rt-net/mevius2/AddInfo/imgs/Picture(6).png

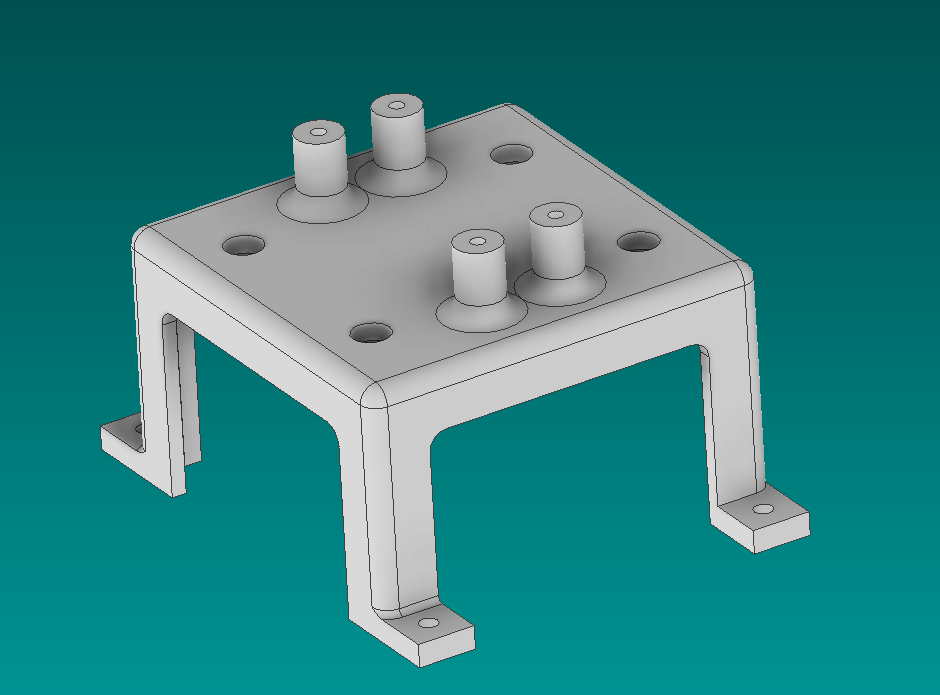
AddInfo/imgs/Picture(6).png
