rt-net/mevius2/AddInfo/Hardware/STL/Lidar-C1unit-Mount.stl

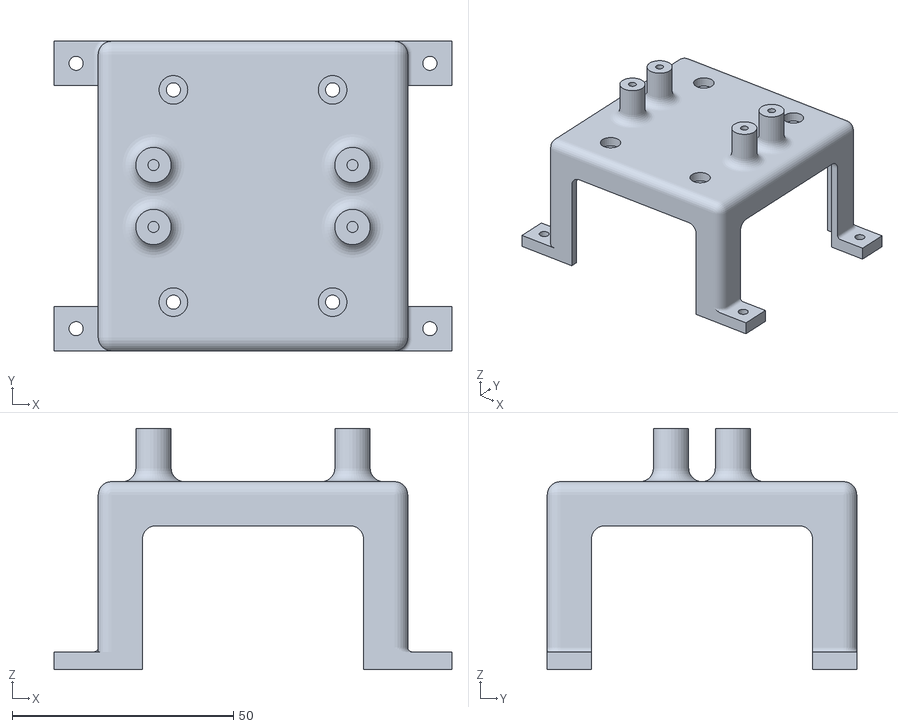
[picture p3: CAD file, 2026-10-27]
AddInfo/Hardware/STL/Lidar-C1unit-Mount.stl
90.0 x 70.0 x 54.5
