rt-net/mevius2/AddInfo/Hardware/STL/Jetson-Mount_LAN_Holder.stl

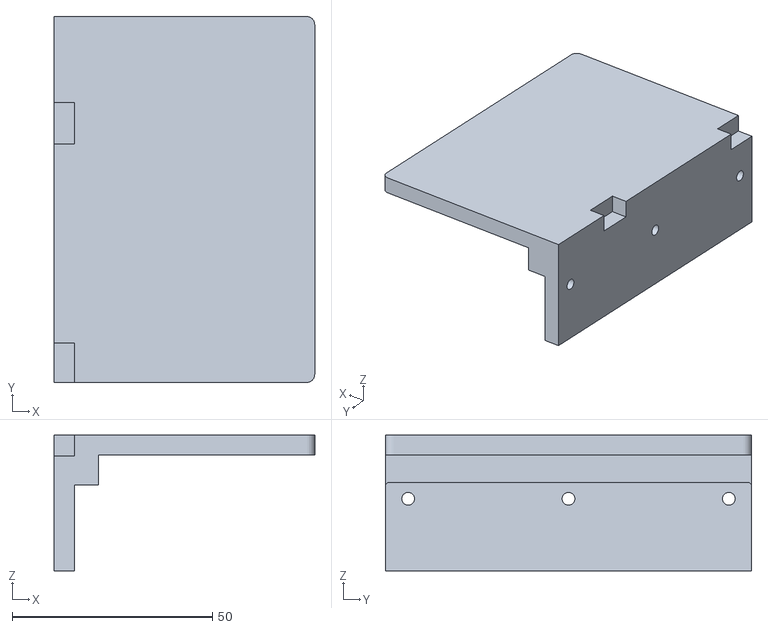
[picture p4: CAD file, 2026-10-27]
AddInfo/Hardware/STL/Jetson-Mount_LAN_Holder.stl
65.0 x 91.3 x 33.9
