rt-net/mevius2/models/mevius2_dae.urdf

<?xml version='1.0' encoding='UTF-8'?>
<robot name="mevius2">
  <link name="base_link">
    <inertial>
      <origin xyz="0.0165960147853653 0.0 0.0549872300199948" rpy="0.0 -0.0 0.0"/>
      <mass value="9.62592165123087"/>
      <inertia ixx="0.0238411422985121" ixy="-7.82998515474365e-06" ixz="0.000608822050897311" iyy="0.0277489409503768" iyz="3.45214164930493e-06" izz="0.0412615906790852"/>
    </inertial>
    <visual>
      <geometry>
        <mesh filename="package://mevius2/models/meshes/base_link.dae"/>
      </geometry>
      <origin xyz="0.0 0.0 0.0" rpy="0.0 -0.0 0.0"/>
    </visual>
    <collision>
      <geometry>
        <box size="0.40 0.211 0.190"/>
      </geometry>
      <origin xyz="0.0 0.0 0.065" rpy="0.0 0.0 0.0"/>
    </collision>
    <collision>
      <geometry>
        <box size="0.07 0.09 0.125"/>
      </geometry>
      <origin xyz="0.368 0.0 0.0625" rpy="0.0 0.0 0.0"/>
    </collision>
  </link>
  <link name="FR_scapula_link">
    <inertial>
      <origin xyz="0.0597359186912743 0.00851610127542549 4.7319717203384e-05" rpy="0.0 -0.0 0.0"/>
      <mass value="1.10755855898182"/>
      <inertia ixx="0.000951820798436067" ixy="-4.20483043113043e-05" ixz="-1.01679999721395e-06" iyy="0.00163047649310399" iyz="-1.28863656505179e-07" izz="0.000884794532952109"/>
    </inertial>
    <visual>
      <geometry>
        <mesh filename="package://mevius2/models/meshes/FR_scapula_link.dae"/>
      </geometry>
      <origin xyz="0.0 0.0 0.0" rpy="0.0 -0.0 0.0"/>
    </visual>
    <collision>
      <geometry>
        <cylinder radius="0.0625" length="0.139"/>
      </geometry>
      <origin xyz="0.0625 -0.0405 0" rpy="1.57 0.0 0.0"/>
    </collision>
  </link>
  <link name="FR_thigh_link">
    <inertial>
      <origin xyz="-0.00546146732125641 -0.05295120372457 -0.0482986549914968" rpy="0.0 -0.0 0.0"/>
      <mass value="1.82653549402785"/>
      <inertia ixx="0.00773006083782414" ixy="-6.24664521180222e-07" ixz="-0.000359149238289752" iyy="0.00887978884347362" iyz="1.51122631673122e-06" izz="0.00131524852670661"/>
    </inertial>
    <visual>
      <geometry>
        <mesh filename="package://mevius2/models/meshes/FR_thigh_link.dae"/>
      </geometry>
      <origin xyz="0.0 0.0 0.0" rpy="0.0 -0.0 0.0"/>
    </visual>
  </link>
  <link name="FR_calf_link">
    <inertial>
      <origin xyz="0.00652657289495578 -6.41512646251674e-06 -0.121361151716941" rpy="0.0 -0.0 0.0"/>
      <mass value="0.266052320574036"/>
      <inertia ixx="0.0015552365359667035" ixy="9.175141422809164e-09" ixz="6.1865695511078285e-06" iyy="0.0015697368632454998" iyz="-9.90647529080357e-08" izz="4.624075442654299e-05"/>
    </inertial>
    <visual>
      <geometry>
        <mesh filename="package://mevius2/models/meshes/FR_calf_link.dae"/>
      </geometry>
      <origin xyz="0.0 0.0 0.0" rpy="0.0 -0.0 0.0"/>
    </visual>
    <collision>
      <geometry>
        <box size="0.021 0.021 0.310"/>
      </geometry>
      <origin xyz="0.01305 0.0 -0.135" rpy="0.0 0.0 0.0"/>
    </collision>
  </link>
  <link name="FR_foot_link">
    <inertial>
      <origin xyz="0.0 0.0 0.0" rpy="0.0 0.0 0.0"/>
      <mass value="0.12"/>
      <inertia ixx="5.3e-05" ixy="0.0" ixz="0.0" iyy="5.3e-05" iyz="0.0" izz="5.3e-05"/>
    </inertial>
    <collision>
      <geometry>
        <sphere radius="0.03"/>
      </geometry>
      <origin xyz="0.0 0.0 0.0" rpy="0.0 0.0 0.0"/>
      <material name="foot">
        <color rgba="1 0 0 1" />
      </material>
    </collision>
  </link>
  <link name="FL_scapula_link">
    <inertial>
      <origin xyz="0.059735918691274 -0.00851610127542556 -4.73197172033216e-05" rpy="0.0 -0.0 0.0"/>
      <mass value="1.10755855898183"/>
      <inertia ixx="0.000951820798436068" ixy="4.20483043113044e-05" ixz="1.01679999721443e-06" iyy="0.00163047649310399" iyz="-1.28863656505136e-07" izz="0.000884794532952109"/>
    </inertial>
    <visual>
      <geometry>
        <mesh filename="package://mevius2/models/meshes/FL_scapula_link.dae"/>
      </geometry>
      <origin xyz="0.0 0.0 0.0" rpy="0.0 -0.0 0.0"/>
    </visual>
    <collision>
      <geometry>
        <cylinder radius="0.0625" length="0.139"/>
      </geometry>
      <origin xyz="0.0625 0.0405 0" rpy="1.57 0.0 0.0"/>
    </collision>
  </link>
  <link name="FL_thigh_link">
    <inertial>
      <origin xyz="-0.00546146732125286 0.0529459082875361 -0.0482412683620331" rpy="0.0 -0.0 0.0"/>
      <mass value="1.82653549402785"/>
      <inertia ixx="0.00773006083782417" ixy="6.24664521188713e-07" ixz="-0.000356450328025656" iyy="0.0088797888434736" iyz="-1.25349900371468e-06" izz="0.00131524852670654"/>
    </inertial>
    <visual>
      <geometry>
        <mesh filename="package://mevius2/models/meshes/FL_thigh_link.dae"/>
      </geometry>
      <origin xyz="0.0 0.0 0.0" rpy="0.0 -0.0 0.0"/>
    </visual>
  </link>
  <link name="FL_calf_link">
    <inertial>
      <origin xyz="0.00652657289495667 -6.41512646301634e-06 -0.121361151716941" rpy="0.0 -0.0 0.0"/>
      <mass value="0.266052320574035"/>
      <inertia ixx="0.0015552365359667035" ixy="9.175141422809164e-09" ixz="6.1865695511078285e-06" iyy="0.0015697368632454998" iyz="-9.90647529080357e-08" izz="4.624075442654299e-05"/>
    </inertial>
    <visual>
      <geometry>
        <mesh filename="package://mevius2/models/meshes/FL_calf_link.dae"/>
      </geometry>
      <origin xyz="0.0 0.0 0.0" rpy="0.0 -0.0 0.0"/>
    </visual>
    <collision>
      <geometry>
        <box size="0.021 0.021 0.310"/>
      </geometry>
      <origin xyz="0.01305 0.0 -0.135" rpy="0.0 0.0 0.0"/>
    </collision>
  </link>
  <link name="FL_foot_link">
    <inertial>
      <origin xyz="0.0 0.0 0.0" rpy="0.0 0.0 0.0"/>
      <mass value="0.12"/>
      <inertia ixx="5.3e-05" ixy="0.0" ixz="0.0" iyy="5.3e-05" iyz="0.0" izz="5.3e-05"/>
    </inertial>
    <collision>
      <geometry>
        <sphere radius="0.03"/>
      </geometry>
      <origin xyz="0.0 0.0 0.0" rpy="0.0 0.0 0.0"/>
      <material name="foot">
        <color rgba="1 0 0 1" />
      </material>
    </collision>
  </link>
  <link name="BR_scapula_link">
    <inertial>
      <origin xyz="-0.059735918691274 0.00851610127542554 -4.73197172033493e-05" rpy="0.0 -0.0 0.0"/>
      <mass value="1.10755855898183"/>
      <inertia ixx="0.000951820798436068" ixy="4.20483043113042e-05" ixz="-1.01679999721433e-06" iyy="0.00163047649310399" iyz="1.28863656505235e-07" izz="0.000884794532952108"/>
    </inertial>
    <visual>
      <geometry>
        <mesh filename="package://mevius2/models/meshes/BR_scapula_link.dae"/>
      </geometry>
      <origin xyz="0.0 0.0 0.0" rpy="0.0 -0.0 0.0"/>
    </visual>
    <collision>
      <geometry>
        <cylinder radius="0.0625" length="0.139"/>
      </geometry>
      <origin xyz="-0.0625 -0.0405 0" rpy="1.57 0.0 0.0"/>
    </collision>
  </link>
  <link name="BR_thigh_link">
    <inertial>
      <origin xyz="-0.00548150334801351 -0.0529628356126009 -0.0487439292644921" rpy="0.0 -0.0 0.0"/>
      <mass value="1.82653549402785"/>
      <inertia ixx="0.00773006083782413" ixy="9.38683196344013e-07" ixz="-0.00035914923828971" iyy="0.0088797888434736" iyz="4.54484176825053e-07" izz="0.0013152485267066"/>
    </inertial>
    <visual>
      <geometry>
        <mesh filename="package://mevius2/models/meshes/BR_thigh_link.dae"/>
      </geometry>
      <origin xyz="0.0 0.0 0.0" rpy="0.0 -0.0 0.0"/>
    </visual>
  </link>
  <link name="BR_calf_link">
    <inertial>
      <origin xyz="0.00652657289495678 -6.41512646298859e-06 -0.121361151716941" rpy="0.0 -0.0 0.0"/>
      <mass value="0.266052320574035"/>
      <inertia ixx="0.0015552365359667035" ixy="9.175141422809164e-09" ixz="6.1865695511078285e-06" iyy="0.0015697368632454998" iyz="-9.90647529080357e-08" izz="4.624075442654299e-05"/>
    </inertial>
    <visual>
      <geometry>
        <mesh filename="package://mevius2/models/meshes/BR_calf_link.dae"/>
      </geometry>
      <origin xyz="0.0 0.0 0.0" rpy="0.0 -0.0 0.0"/>
    </visual>
    <collision>
      <geometry>
        <box size="0.021 0.021 0.310"/>
      </geometry>
      <origin xyz="0.01305 0.0 -0.135" rpy="0.0 0.0 0.0"/>
    </collision>
  </link>
  <link name="BR_foot_link">
    <inertial>
      <origin xyz="0.0 0.0 0.0" rpy="0.0 0.0 0.0"/>
      <mass value="0.12"/>
      <inertia ixx="5.3e-05" ixy="0.0" ixz="0.0" iyy="5.3e-05" iyz="0.0" izz="5.3e-05"/>
    </inertial>
    <collision>
      <geometry>
        <sphere radius="0.03"/>
      </geometry>
      <origin xyz="0.0 0.0 0.0" rpy="0.0 0.0 0.0"/>
      <material name="foot">
        <color rgba="1 0 0 1" />
      </material>
    </collision>
  </link>
  <link name="BL_scapula_link">
    <inertial>
      <origin xyz="-0.0597327134434165 -0.00851610127542554 4.73197172034118e-05" rpy="0.0 -0.0 0.0"/>
      <mass value="1.10755855898182"/>
      <inertia ixx="0.000951820798436067" ixy="-4.20483043113044e-05" ixz="1.01679999721446e-06" iyy="0.00163047649310399" iyz="1.28863656505084e-07" izz="0.000884794532952106"/>
    </inertial>
    <visual>
      <geometry>
        <mesh filename="package://mevius2/models/meshes/BL_scapula_link.dae"/>
      </geometry>
      <origin xyz="0.0 0.0 0.0" rpy="0.0 -0.0 0.0"/>
    </visual>
    <collision>
      <geometry>
        <cylinder radius="0.0625" length="0.139"/>
      </geometry>
      <origin xyz="-0.0625 0.0405 0" rpy="1.57 0.0 0.0"/>
    </collision>
  </link>
  <link name="BL_thigh_link">
    <inertial>
      <origin xyz="-0.00546146732125374 0.052955061332363 -0.0487439292644919" rpy="0.0 -0.0 0.0"/>
      <mass value="1.82653549402785"/>
      <inertia ixx="0.0077300608378242" ixy="6.24664521200288e-07" ixz="-0.000356450328025635" iyy="0.0088797888434736" iyz="-4.54484176825552e-07" izz="0.00131524852670657"/>
    </inertial>
    <visual>
      <geometry>
        <mesh filename="package://mevius2/models/meshes/BL_thigh_link.dae"/>
      </geometry>
      <origin xyz="0.0 0.0 0.0" rpy="0.0 -0.0 0.0"/>
    </visual>
  </link>
  <link name="BL_calf_link">
    <inertial>
      <origin xyz="0.00652657289495678 -6.4151264630441e-06 -0.121361151716941" rpy="0.0 -0.0 0.0"/>
      <mass value="0.266052320574035"/>
      <inertia ixx="0.0015552365359667035" ixy="9.175141422809164e-09" ixz="6.1865695511078285e-06" iyy="0.0015697368632454998" iyz="-9.90647529080357e-08" izz="4.624075442654299e-05"/>
    </inertial>
    <visual>
      <geometry>
        <mesh filename="package://mevius2/models/meshes/BL_calf_link.dae"/>
      </geometry>
      <origin xyz="0.0 0.0 0.0" rpy="0.0 -0.0 0.0"/>
    </visual>
    <collision>
      <geometry>
        <box size="0.021 0.021 0.310"/>
      </geometry>
      <origin xyz="0.01305 0.0 -0.135" rpy="0.0 0.0 0.0"/>
    </collision>
  </link>
  <link name="BL_foot_link">
    <inertial>
      <origin xyz="0.0 0.0 0.0" rpy="0.0 0.0 0.0"/>
      <mass value="0.12"/>
      <inertia ixx="5.3e-05" ixy="0.0" ixz="0.0" iyy="5.3e-05" iyz="0.0" izz="5.3e-05"/>
    </inertial>
    <collision>
      <geometry>
        <sphere radius="0.03"/>
      </geometry>
      <origin xyz="0.0 0.0 0.0" rpy="0.0 0.0 0.0"/>
      <material name="foot">
        <color rgba="1 0 0 1" />
      </material>
    </collision>
  </link>
  <joint name="FR_collar_joint" type="revolute">
    <limit lower="-0.7854" upper="0.7854" effort="60" velocity="18.85"/>
    <parent link="base_link"/>
    <child link="FR_scapula_link"/>
    <axis xyz="1. 0. 0."/>
    <origin xyz="0.203 -0.080000000000003 0.0620000000000024" rpy="0.0 -0.0 0.0"/>
  </joint>
  <joint name="FR_hip_joint" type="revolute">
    <limit lower="-1.0472" upper="2.6180" effort="60" velocity="18.85"/>
    <parent link="FR_scapula_link"/>
    <child link="FR_thigh_link"/>
    <axis xyz=" 0. 1. 0."/>
    <origin xyz="0.0625000000000009 -0.0159999999999999 0.0" rpy="0.0 -0.0 0.0"/>
  </joint>
  <joint name="FR_knee_joint" type="revolute">
    <limit lower="-2.8508" upper="-0.7812" effort="60" velocity="18.85"/>
    <parent link="FR_thigh_link"/>
    <child link="FR_calf_link"/>
    <axis xyz="0. 1. 0."/>
    <origin xyz="0.0 -0.0769999999999996 -0.3" rpy="0.0 -0.0 0.0"/>
  </joint>
  <joint name="FR_ankle_joint" type="fixed" dont_collapse="true">
    <origin xyz="0.00263 0.0 -0.285" rpy="0 0 0"/>
    <parent link="FR_calf_link"/>
    <child link="FR_foot_link"/>
  </joint>
  <joint name="FL_collar_joint" type="revolute">
    <limit lower="-0.7854" upper="0.7854" effort="60" velocity="18.85"/>
    <parent link="base_link"/>
    <child link="FL_scapula_link"/>
    <axis xyz="1. 0. 0."/>
    <origin xyz="0.203 0.079999999999999 0.0620000000000025" rpy="0.0 -0.0 0.0"/>
  </joint>
  <joint name="FL_hip_joint" type="revolute">
    <limit lower="-1.0472" upper="2.6180" effort="60" velocity="18.85"/>
    <parent link="FL_scapula_link"/>
    <child link="FL_thigh_link"/>
    <axis xyz="0. 1. 0."/>
    <origin xyz="0.062500000000001 0.016 0.0" rpy="0.0 -0.0 0.0"/>
  </joint>
  <joint name="FL_knee_joint" type="revolute">
    <limit lower="-2.8508" upper="-0.7812" effort="60" velocity="18.85"/>
    <parent link="FL_thigh_link"/>
    <child link="FL_calf_link"/>
    <axis xyz=" 0. 1. 0."/>
    <origin xyz="0.0 0.077 -0.3" rpy="0.0 -0.0 0.0"/>
  </joint>
  <joint name="FL_ankle_joint" type="fixed" dont_collapse="true">
    <origin xyz="0.00263 0.0 -0.285" rpy="0 0 0"/>
    <parent link="FL_calf_link"/>
    <child link="FL_foot_link"/>
  </joint>
  <joint name="BR_collar_joint" type="revolute">
    <limit lower="-0.7854" upper="0.7854" effort="60" velocity="18.85"/>
    <parent link="base_link"/>
    <child link="BR_scapula_link"/>
    <axis xyz="1. 0. 0."/>
    <origin xyz="-0.203 -0.080000000000003 0.0620000000000024" rpy="0.0 -0.0 0.0"/>
  </joint>
  <joint name="BR_hip_joint" type="revolute">
    <limit lower="-1.0472" upper="2.6180" effort="60" velocity="18.85"/>
    <parent link="BR_scapula_link"/>
    <child link="BR_thigh_link"/>
    <axis xyz=" 0. 1. 0."/>
    <origin xyz="-0.0625000000000009 -0.016 0.0" rpy="0.0 -0.0 0.0"/>
  </joint>
  <joint name="BR_knee_joint" type="revolute">
    <limit lower="-2.8508" upper="-0.7812" effort="60" velocity="18.85"/>
    <parent link="BR_thigh_link"/>
    <child link="BR_calf_link"/>
    <axis xyz="0. 1. 0."/>
    <origin xyz="0.0 -0.0769999999999996 -0.3" rpy="0.0 -0.0 0.0"/>
  </joint>
  <joint name="BR_ankle_joint" type="fixed" dont_collapse="true">
    <origin xyz="0.00263 0.0 -0.285" rpy="0 0 0"/>
    <parent link="BR_calf_link"/>
    <child link="BR_foot_link"/>
  </joint>
  <joint name="BL_collar_joint" type="revolute">
    <limit lower="-0.7854" upper="0.7854" effort="60" velocity="18.85"/>
    <parent link="base_link"/>
    <child link="BL_scapula_link"/>
    <axis xyz="1. 0. 0."/>
    <origin xyz="-0.203 0.0800000000000028 0.0620000000000025" rpy="0.0 -0.0 0.0"/>
  </joint>
  <joint name="BL_hip_joint" type="revolute">
    <limit lower="-1.0472" upper="2.6180" effort="60" velocity="18.85"/>
    <parent link="BL_scapula_link"/>
    <child link="BL_thigh_link"/>
    <axis xyz="0. 1. 0."/>
    <origin xyz="-0.0625000000000011 0.016 0.0" rpy="0.0 -0.0 0.0"/>
  </joint>
  <joint name="BL_knee_joint" type="revolute">
    <limit lower="-2.8508" upper="-0.7812" effort="60" velocity="18.85"/>
    <parent link="BL_thigh_link"/>
    <child link="BL_calf_link"/>
    <axis xyz=" 0. 1. 0."/>
    <origin xyz="0.0 0.077 -0.300000000000005" rpy="0.0 -0.0 0.0"/>
  </joint>
  <joint name="BL_ankle_joint" type="fixed" dont_collapse="true">
    <origin xyz="0.00263 0.0 -0.285" rpy="0 0 0"/>
    <parent link="BL_calf_link"/>
    <child link="BL_foot_link"/>
  </joint>
</robot>
